AllenNeuralDynamics/harp.device.environment-sensor/software/python/README.md

# Python drivers for the environment sensor

Contains a small package to interface with the environment sensor device, and a script runnable with `python -m harp_env_sensor.main` to read the data and optionally save it to a csv file.

## Installation

`pip install "git+https://github.com/AllenNeuralDynamics/harp.device.environment-sensor.git@feat-add-python-script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" --force-reinstall`

If you're on a SIPE computer with the default pip environment variables set to the devpi server, you'll need to add `-i https://pypi.org/simple` after the pip install above.

## Usage

CLI Arguments:
- `--comport` Port name where the device is connected. Optional. If missing, it'll list available ports and prompt.
- `--mode` Read mode
    - `single`: Takes one reading, prints it to terminal, and exits
    - `events`: Polls events as they come in and print to terminal and file if provided
    - `continuous`: Reads registers every <update_interval_s> seconds and print to terminal and file if provided
- `--file` Path to file to write output to. Optional.
- `--device-yaml` Path to device yaml file. Optional, defaults to hardcoded values
- `--update_interval_s` If in continuous mode, read registers with this period. Optional, defaults 1.5

Examples:

- Read events from COM8 and save to file

    `python -m harp_env_sensor.main --comport COM8 --mode events --file ./output.csv`

- Read the registers regularly and print to terminal

    `python -m harp_env_sensor.main --comport COM8 --mode continuous`
  
- Read the registers every 5 s and print to terminal

    `python -m harp_env_sensor.main --comport COM8 --mode continuous --update_interval_s 5`
