AllenNeuralDynamics/harp.device.environment-sensor/hardware/board/environment_sensor/environment_sensor.kicad_pcb

## KiCad design hardware/board/environment_sensor/environment_sensor.kicad_pcb (2024-11-08)

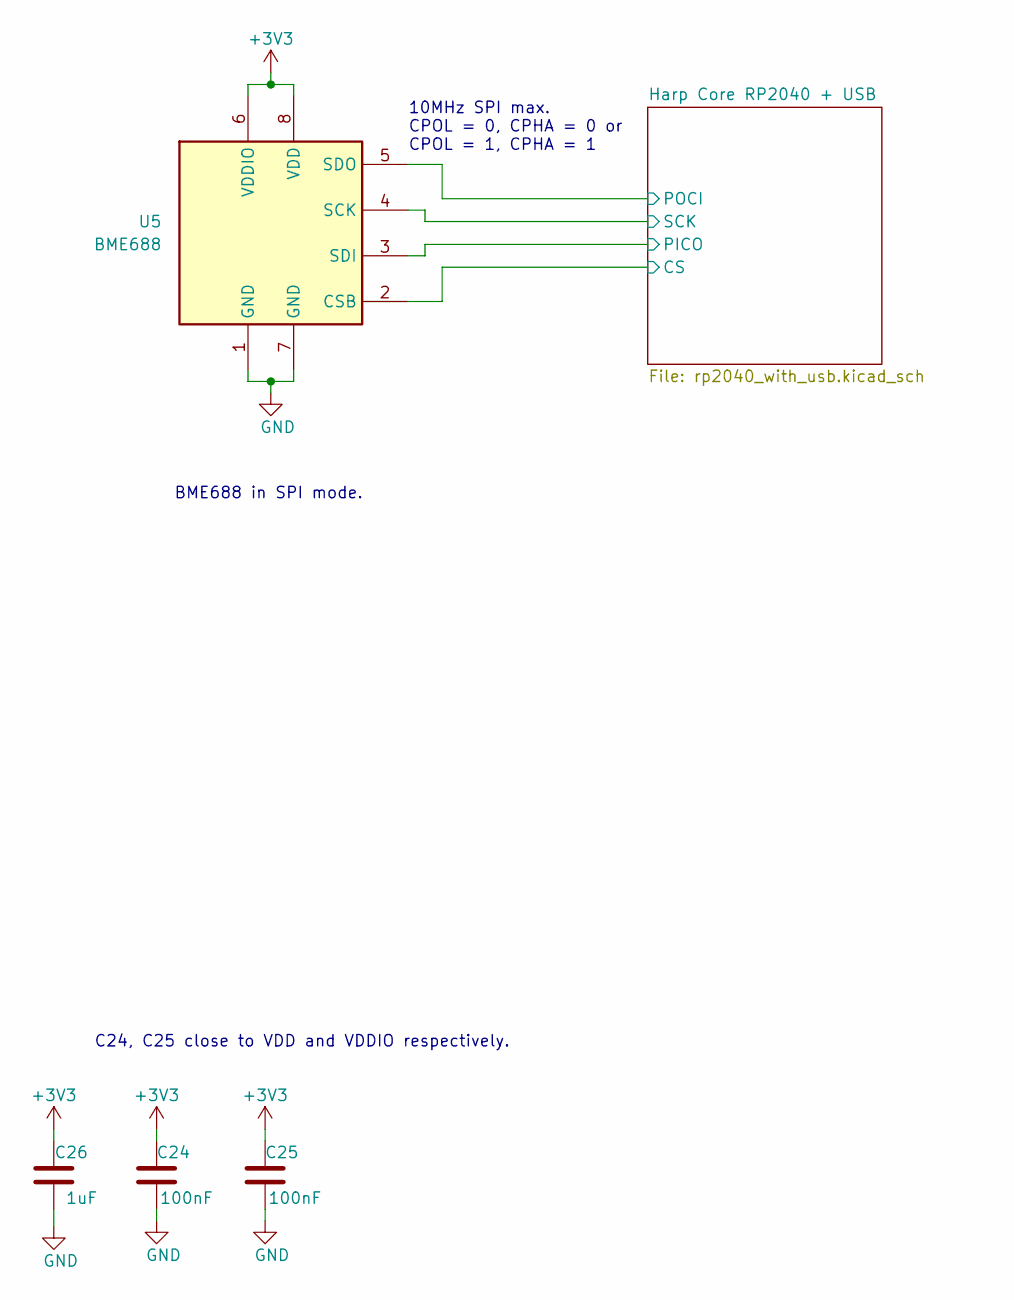
[picture p1: schematic environment_sensor.kicad_sch]

Parts:
C24, C25: 100nF; C_0402_1005Metric; Rated Voltage 16V; Tolerance 10%
C26: 1uF; C_0402_1005Metric; Rated Voltage 35V
U5: BME688; Bosch_LGA-8_3x3mm_P0.8mm_ClockwisePinNumbering

Connections:
+3V3: C24.2, C25.2, C26.1, U5.6 (VDDIO), U5.8 (VDD); also elsewhere on the board
/Harp Core RP2040 + USB/CS: U5.2 (CSB); also elsewhere on the board
/Harp Core RP2040 + USB/PICO: U5.3 (SDI); also elsewhere on the board
/Harp Core RP2040 + USB/POCI: U5.5 (SDO); also elsewhere on the board
/Harp Core RP2040 + USB/SCK: U5.4 (SCK); also elsewhere on the board
GND: C24.1, C25.1, C26.2, U5.1 (GND), U5.7 (GND); also elsewhere on the board

Notes on the sheet:
10MHz SPI max. CPOL = 0, CPHA = 0 or CPOL = 1, CPHA = 1
C24, C25 close to VDD and VDDIO respectively.
BME688 in SPI mode.

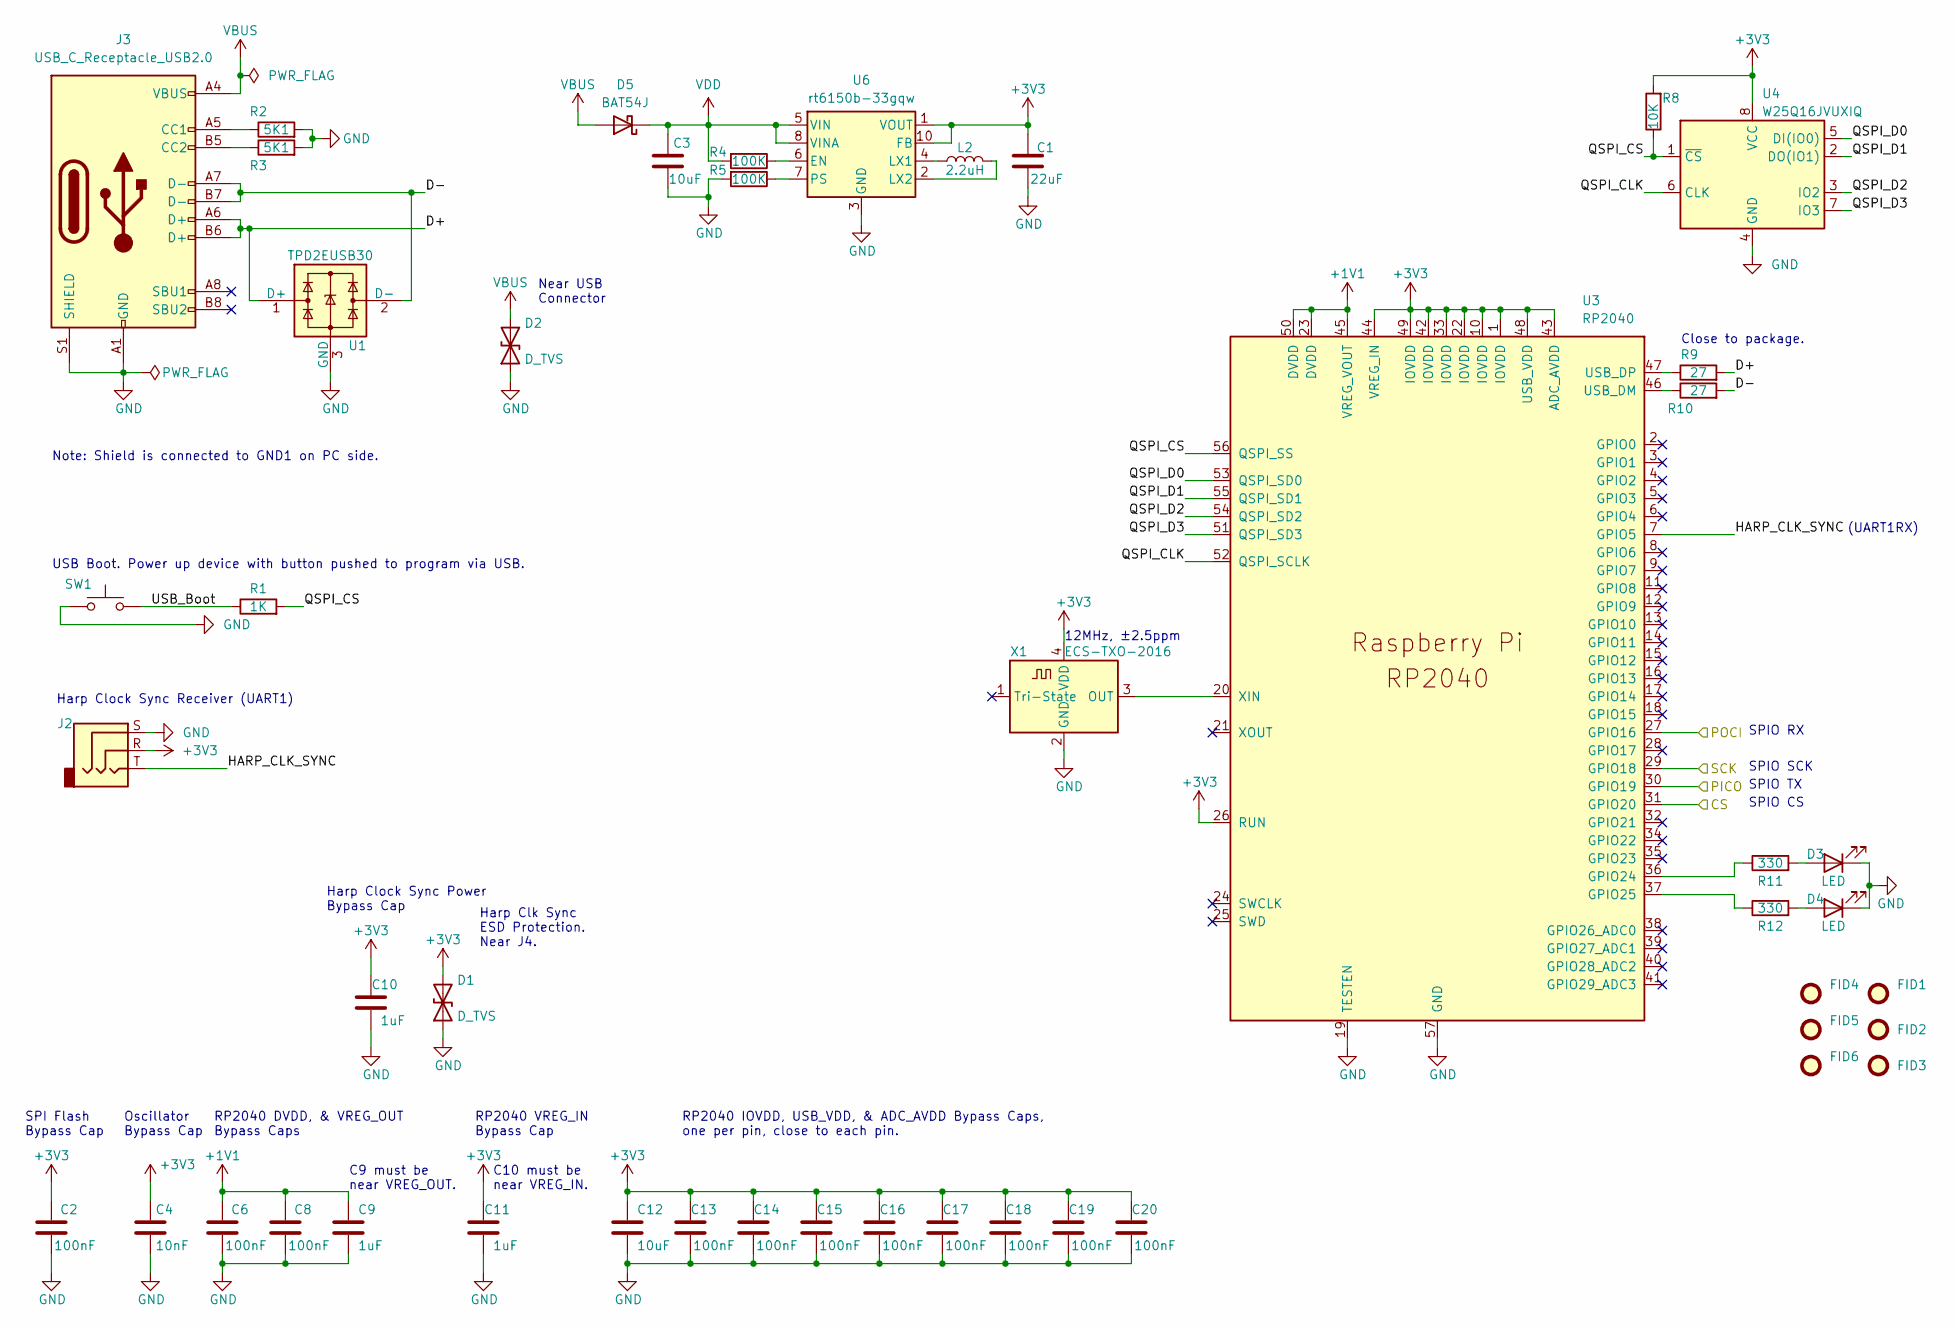
[picture p2: schematic rp2040_with_usb.kicad_sch]

Parts:
C1: 22uF; C_0805_2012Metric; Rated Voltage 10V
C2, C6, C8, C13, C14, C15, C16, C17, C18, C19, C20: 100nF; C_0402_1005Metric; Rated Voltage 16V; Tolerance 10%
C3, C12: 10uF; C_0805_2012Metric; Rated Voltage 25V
C4: 10nF; C_0402_1005Metric; Rated Voltage 25V; Tolerance 2%
C9, C10, C11: 1uF; C_0402_1005Metric; Rated Voltage 35V
D1, D2: D_TVS; D_0402_1005Metric
D3, D4: LED; LED_0603_1608Metric_Pad1.05x0.95mm_HandSolder
D5: BAT54J; D_SOD-323F
FID1, FID2, FID3, FID4, FID5, FID6: Fiducial; Fiducial_0.5mm_Mask1mm
J2: AudioJack3; Jack_3.5mm_CUI_SJ-3524-SMT_Horizontal
J3: USB_C_Receptacle_USB2.0; USB_C_Receptacle_JAE_DX07S016JA1R1500
L2: 2.2uH; L_0603_1608Metric
R1: 1K; R_0402_1005Metric; Tolerance 1%
R2, R3: 5K1; R_0402_1005Metric; Tolerance 1%
R4, R5: 100K; R_0402_1005Metric; Tolerance 1%
R8: 10K; R_0402_1005Metric; Tolerance 1%
R9, R10: 27; R_0402_1005Metric; Tolerance 1%
R11, R12: 330; R_0402_1005Metric; Tolerance 0.1%
SW1: SW_Push; SW_SPST_B3U-1000P
U1: TPD2EUSB30; Texas_DRT-3
U3: RP2040; RP2040-QFN-56
U4: W25Q16JVUXIQ; Winbond-8USON-2x3mm
U6: rt6150b-33gqw; WDFN-10-1EP_2.5x2.5mm_P0.5_EP1.25x2.1mm
X1: ECS-TXO-2016; Crystal_SMD_2016-4Pin_2.0x1.6mm; Tolerance ±2.5ppm

Connections:
+1V1: C6.2, C8.2, C9.1, U3.23 (DVDD), U3.45 (VREG_VOUT), U3.50 (DVDD)
+3V3: C1.2, C2.2, C4.1, C10.1, C11.1, C12.1, C13.2, C14.2, C15.2, C16.2, C17.2, C18.2, C19.2, C20.2, D1.2 (A2), J2.R, R8.2, U3.1 (IOVDD), U3.10 (IOVDD), U3.22 (IOVDD), U3.26 (RUN), U3.33 (IOVDD), U3.42 (IOVDD), U3.43 (ADC_AVDD), U3.44 (VREG_IN), U3.48 (USB_VDD), U3.49 (IOVDD), U4.8 (VCC), U6.1 (VOUT), U6.10 (FB), X1.4 (VDD); also elsewhere on the board
/Harp Core RP2040 + USB/CS: U3.31 (GPIO20); also elsewhere on the board
/Harp Core RP2040 + USB/D+: J3.A6 (D+), J3.B6 (D+), R9.2, U1.1 (D+)
/Harp Core RP2040 + USB/D-: J3.A7 (D-), J3.B7 (D-), R10.2, U1.2 (D-)
/Harp Core RP2040 + USB/HARP_CLK_SYNC: J2.T, U3.7 (GPIO5)
/Harp Core RP2040 + USB/PICO: U3.30 (GPIO19); also elsewhere on the board
/Harp Core RP2040 + USB/POCI: U3.27 (GPIO16); also elsewhere on the board
/Harp Core RP2040 + USB/QSPI_CLK: U3.52 (QSPI_SCLK), U4.6 (CLK)
/Harp Core RP2040 + USB/QSPI_CS: R1.2, R8.1, U3.56 (QSPI_SS), U4.1 (~CS)
/Harp Core RP2040 + USB/QSPI_D0: U3.53 (QSPI_SD0), U4.5 (DI(IO0))
/Harp Core RP2040 + USB/QSPI_D1: U3.55 (QSPI_SD1), U4.2 (DO(IO1))
/Harp Core RP2040 + USB/QSPI_D2: U3.54 (QSPI_SD2), U4.3 (IO2)
/Harp Core RP2040 + USB/QSPI_D3: U3.51 (QSPI_SD3), U4.7 (IO3)
/Harp Core RP2040 + USB/SCK: U3.29 (GPIO18); also elsewhere on the board
/Harp Core RP2040 + USB/USB_Boot: R1.1, SW1.2
GND: C1.1, C2.1, C3.2, C4.2, C6.1, C8.1, C9.2, C10.2, C11.2, C12.2, C13.1, C14.1, C15.1, C16.1, C17.1, C18.1, C19.1, C20.1, D1.1 (A1), D2.1 (A1), D3.1 (K), D4.1 (K), J2.S, J3.A1 (GND), J3.A12 (GND), J3.B1 (GND), J3.B12 (GND), J3.S1 (SHIELD), R2.2, R3.2, R5.2, SW1.1, U1.3 (GND), U3.19 (TESTEN), U3.57 (GND), U4.4 (GND), U6.3 (GND), U6.9 (GND), U6.11 (GND), X1.2 (GND); also elsewhere on the board
unnamed: D3.2 (A), R11.2
unnamed: D4.2 (A), R12.2
unnamed: J3.A5 (CC1), R2.1
unnamed: J3.B5 (CC2), R3.1
unnamed: R11.1, U3.36 (GPIO24)
unnamed: R12.1, U3.37 (GPIO25)
unnamed: R10.1, U3.46 (USB_DM)
unnamed: R9.1, U3.47 (USB_DP)
unnamed: U3.20 (XIN), X1.3 (OUT)
unnamed: R4.1, U6.6 (EN)
unnamed: L2.1, U6.4 (LX1)
unnamed: L2.2, U6.2 (LX2)
unnamed: R5.1, U6.7 (PS)
VBUS: D2.2 (A2), D5.2 (A), J3.A4 (VBUS), J3.A9 (VBUS), J3.B4 (VBUS), J3.B9 (VBUS)
VDD: C3.1, D5.1 (K), R4.2, U6.5 (VIN), U6.8 (VINA)

Notes on the sheet:
C10 must be near VREG_IN.
SPIO SCK
C9 must be near VREG_OUT.
SPI Flash Bypass Cap
Close to package.
Harp Clock Sync Power Bypass Cap
Harp Clock Sync Receiver (UART1)
Oscillator Bypass Cap
RP2040 DVDD, & VREG_OUT Bypass Caps
RP2040 VREG_IN Bypass Cap
USB Boot. Power up device with button pushed to program via USB.
(UART1RX)
RP2040 IOVDD, USB_VDD, & ADC_AVDD Bypass Caps, one per pin, close to each pin.
Near USB Connector
Note: Shield is connected to GND1 on PC side.
SPIO CS
12MHz, ±2.5ppm
Harp Clk Sync ESD Protection. Near J4.
SPIO TX
SPIO RX

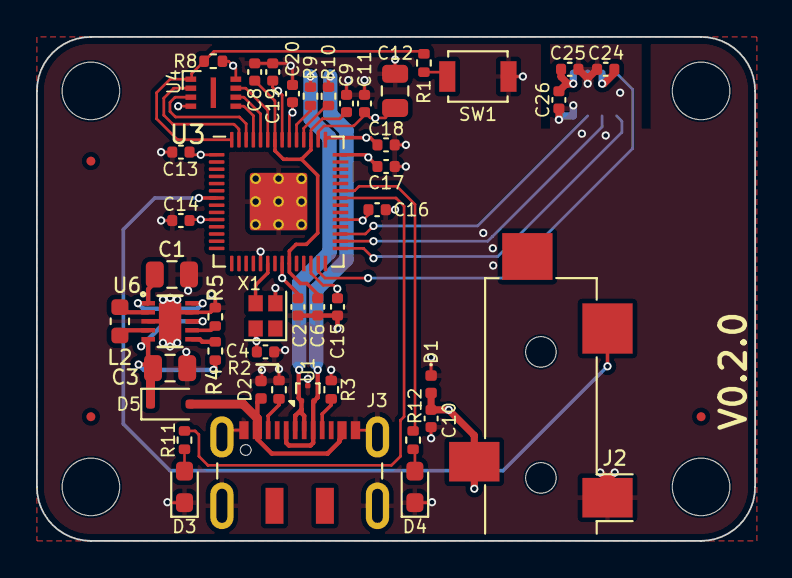
[picture p3: board environment_sensor.kicad_pcb from above]

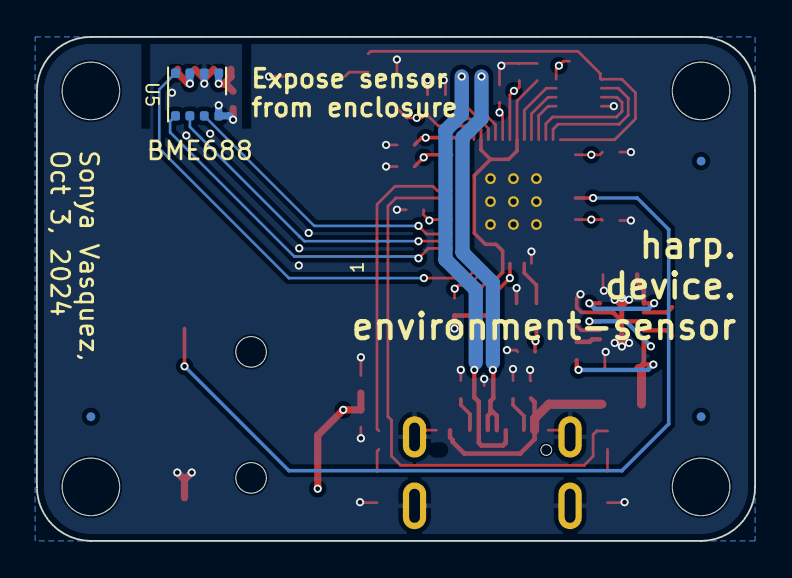
[picture p4: board environment_sensor.kicad_pcb from below]

Board: 4 copper layers, 39.9 x 28.0 mm, 52 parts (4 on the bottom side), 32 nets.
