AllenNeuralDynamics/harp.device.environment-sensor/(threads)

Thread 2 (2024-10-02):

1.0 PCB Self-Heating

Poofjunior, 2024-10-02:
The PCB has ~3 degrees C of self-heating.

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

Putting the PCB in an enclosure will make the effect worse.

The primary source of heat is likely the LDO regulator. (These are inherently inefficient because they burn off excess voltage as heat.) The next suspects are the LEDs (LEDs were blinking in this case) and then the MCU.

There are a few options here:
1. Move the sensor to the corner of the board
2. Add cutouts to the ground plane around the sensor to reduce sensitivity
3. Switch the LDO regulator for a switching regulator.
4. Lower the clock frequency of the MCU

>[!NOTE]
> It's worth confirming that the regulator is the problem using a thermal camera.

### Regulator Option

The RT6150B is a good candidate for a new power supply option. It is 90% efficient in the operating region we will use, and it's identical to what's used on the Pico 2 board. See [Pico 2 Datasheet](https://datasheets.raspberrypi.com/pico/pico-2-datasheet.pdf). It will cost more board space, though.

Poofjunior, 2024-10-03:
Update: Board has been redesigned with the following changes.

## Top
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
## Bottom
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

* added keepout regions for copper-poured features on all layers around the sensor to reduce heat transfer
* swapped linear regulator for a switching regulator that is 90% efficient
* moved the sensor to the corner of the board, further away from primary heat sources.
* increased PCB size to accommodate M3 mounting holes
* moved USB C connector and audio jack off of the board edge to account for case width.

Poofjunior, 2024-10-04:
Final board has an exposed thermal pad on the bottom:
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

Worst case: we can also put a heatsink on the RP2040 directly:
[Heatsink option](https://www.adafruit.com/product/1515)

Poofjunior, 2024-10-31:
V0.2.0 PCB self-heating looks a lot better. That's about 1-deg C of self-heating over 40ish minutes.

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

Thread 6 (2024-10-31):

Flesh out Arduino Serial Shim

patricklatimer, 2024-10-31:
The Adafruit driver for the BME680 is written for Arduino and calls various arduino-native functions. We've shimmed some of those in Arduino.h/cpp, but not the Serial class (print and println methods), as those methods have many type overloads so it's not as simple as just calling printf.

This doesn't affect normal operation, but if we wanted to use the BME680_DEBUG option to print debug info from the sensor, we'd need the shim.

Having this would also make it easier to use arduino libraries on other pico projects.

Here's an example of something that could probably be leveraged:
https://github.com/earlephilhower/ArduinoCore-API/blob/master/api/Print.h

Thread 10 (2024-11-26):

Add temp offset in firmware

patricklatimer, 2024-11-26:
The boards being tested seem to be around 5C too high. We should add a settable offset for each of the values into the firmware.

nathan-mars, 2025-01-14:
Joon is working on collecting validated temperature readings so we know what the offset should be, once we're able to set it in firmware.

Closed 2025-02-19.

Thread 17 (2025-02-28):

Move Environment Sensor BOOTSEL button to opposite side of PCB

Poofjunior, 2025-02-28:
With the BME688 on one side of the PCBA, and the remaining components on the other side, accessing the button once the device has been installed on a mounting point is not possible.

While we don't normally need access to this button once working firmware has been uploaded at least once, moving the button would give us the flexibility to flash the device without removing it from its installation location under any circumstance.
