AllenNeuralDynamics/harp.device.environment-sensor/firmware/inc/core1_sensor.h

#ifndef CORE1_SENSOR_H
#define CORE1_SENSOR_H

#include <config.h>
#include <pico/util/queue.h>
#include "Adafruit_BME680_rpi.h"

#pragma pack(push, 1)
struct sensor_data_t
{
    uint32_t pressure_pa;  
    float temperature_c;   
    float humidity_prh;  
};
#pragma pack(pop)

extern queue_t sensor_queue;
extern queue_t cmd_queue;

bool core1_setup();

void core1_main();

#endif
