AllenNeuralDynamics/harp.device.environment-sensor/(commit log)

2024-10-23 Add device.yml
2024-10-23 Update harp.core.rp2040 pin
2024-10-29 Refactor shim functions into Arduino.h
2024-10-30 Update harp device name
2024-10-30 Put harp device name in config.h
2024-10-31 Read info and whoAmI from device.yml
2024-11-08 Make de-multiplexed registers read-only
2024-11-08 Expose multiplexed sensor data via nested object
2024-11-08 update 3d shapes for audio jack
    [environment_sensor.kicad_pcb]
2024-11-08 Update bonsai generators to embedded device metadata in assembly
2024-11-10 Favor harp-tech as source of device schema
2024-11-22 Add --device-yaml arg with default
2025-02-06 adding temperature offset and adjustment to lower sys clock speed
2025-02-14 Update pyharp commit pin
